AhmedHafez2000/Battery-Capacity-Tester/PCB/README.md

# Pritable PCB
It is a file for DIY project and it represents the bottom side of PCB.
The top side connections are jumper wires.
 
NOTE: Make sure to print the file in actual size scale
