AhmedHafez2000/Battery-Capacity-Tester/PCB/2D-Top.png

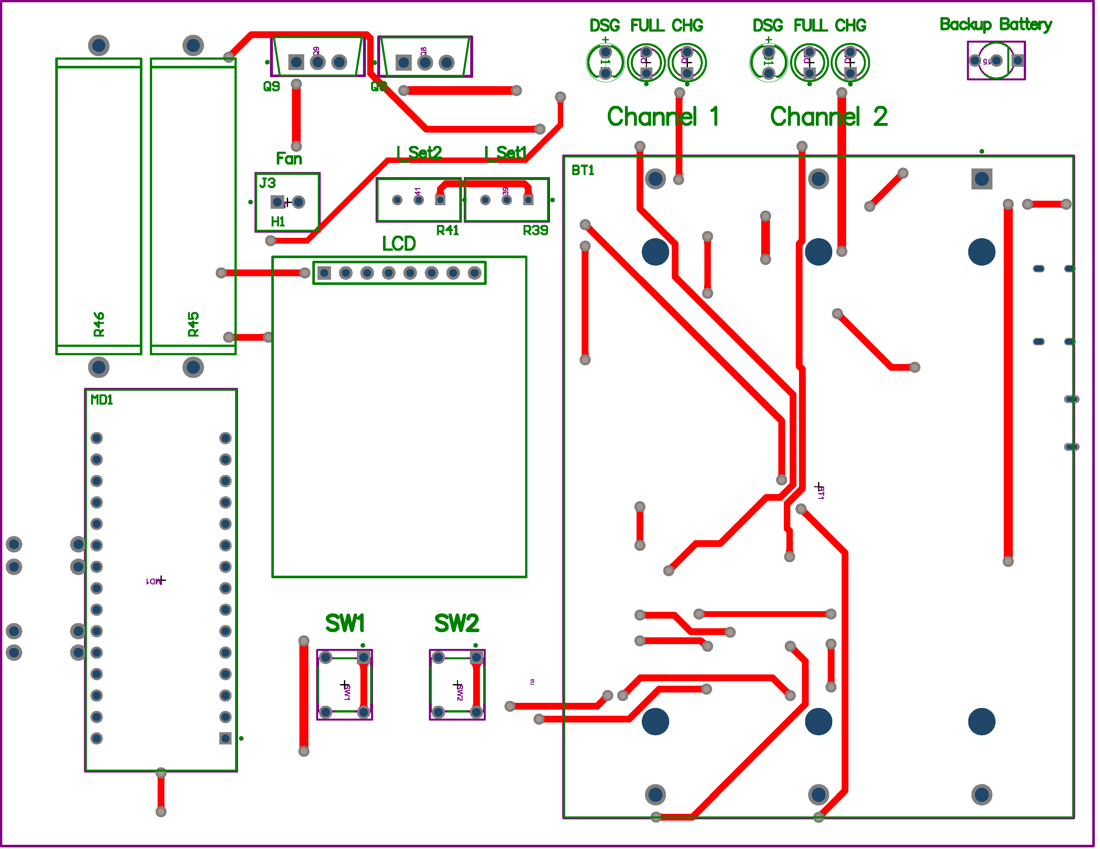
PCB/2D-Top.png
