AhmedHafez2000/Battery-Capacity-Tester/Photos/Current Calibaration Points.png

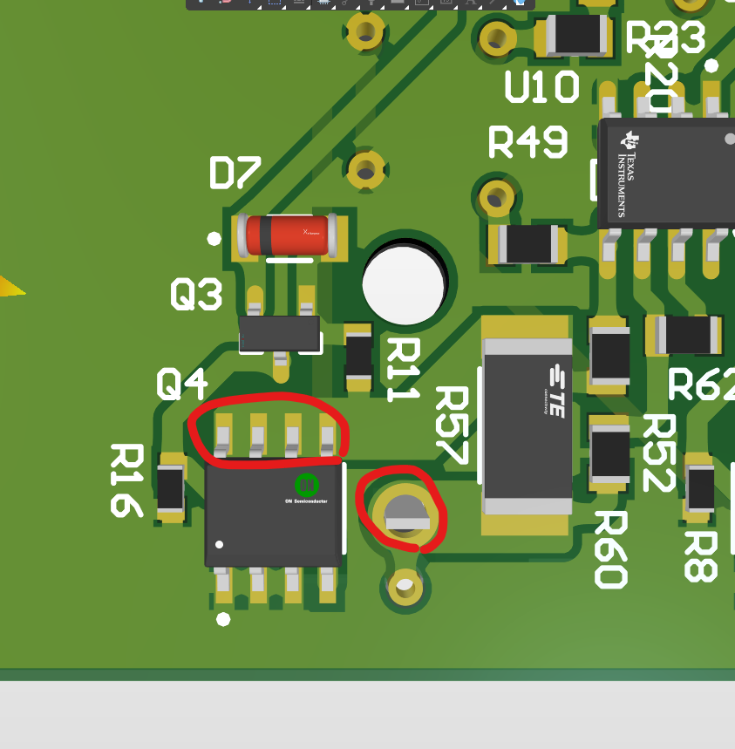
Photos/Current Calibaration Points.png
