AhmedHafez2000/Battery-Capacity-Tester/Photos/IMG_2.jpg

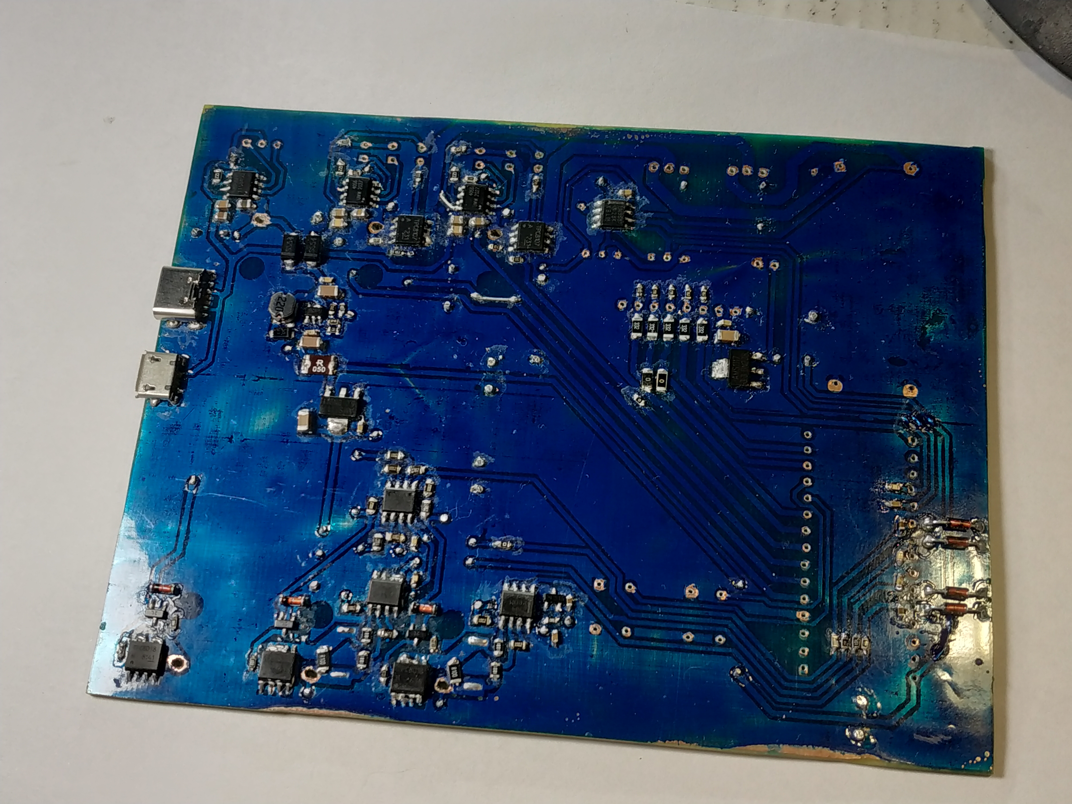
Photos/IMG_2.jpg
