AhmedHafez2000/Battery-Capacity-Tester/Photos/IMG_4.jpg

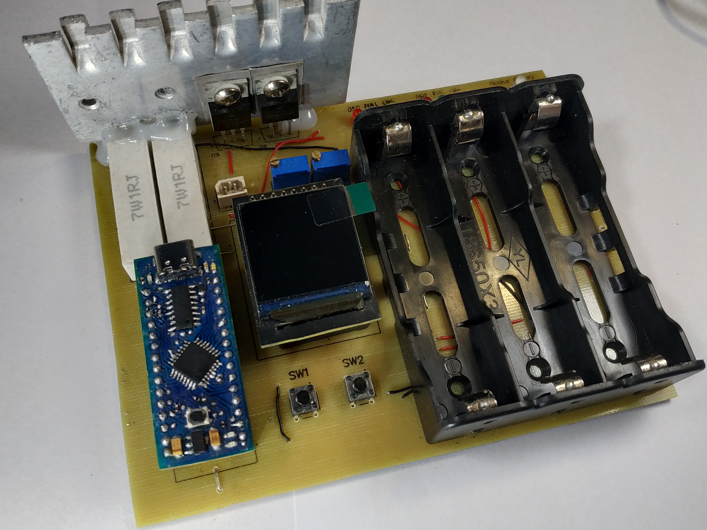
Photos/IMG_4.jpg
