AhmedHafez2000/Battery-Capacity-Tester/Photos/IMG_7.jpg

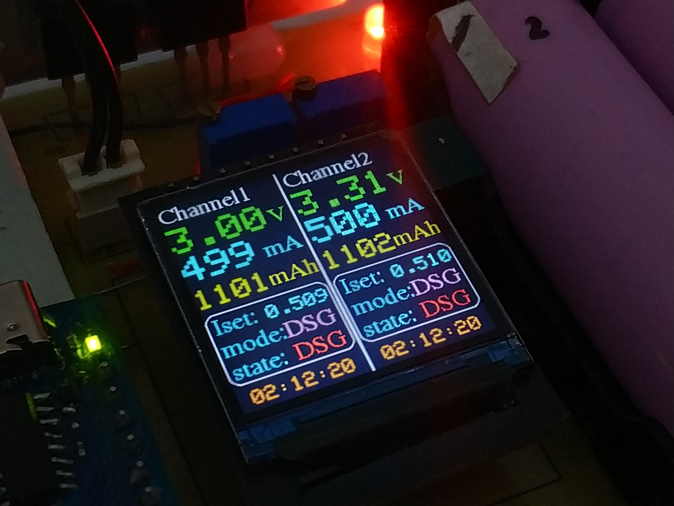
Photos/IMG_7.jpg
