AhmedHafez2000/Battery-Capacity-Tester/Photos/IMG_10.jpg

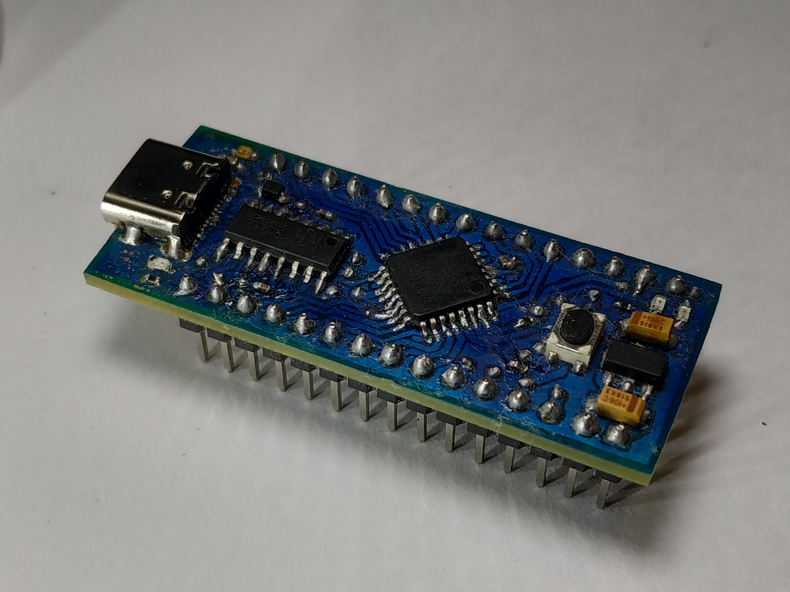
Photos/IMG_10.jpg
