AhmedHafez2000/Battery-Capacity-Tester/Schematic/Schematic_Battery_Tester.PDF

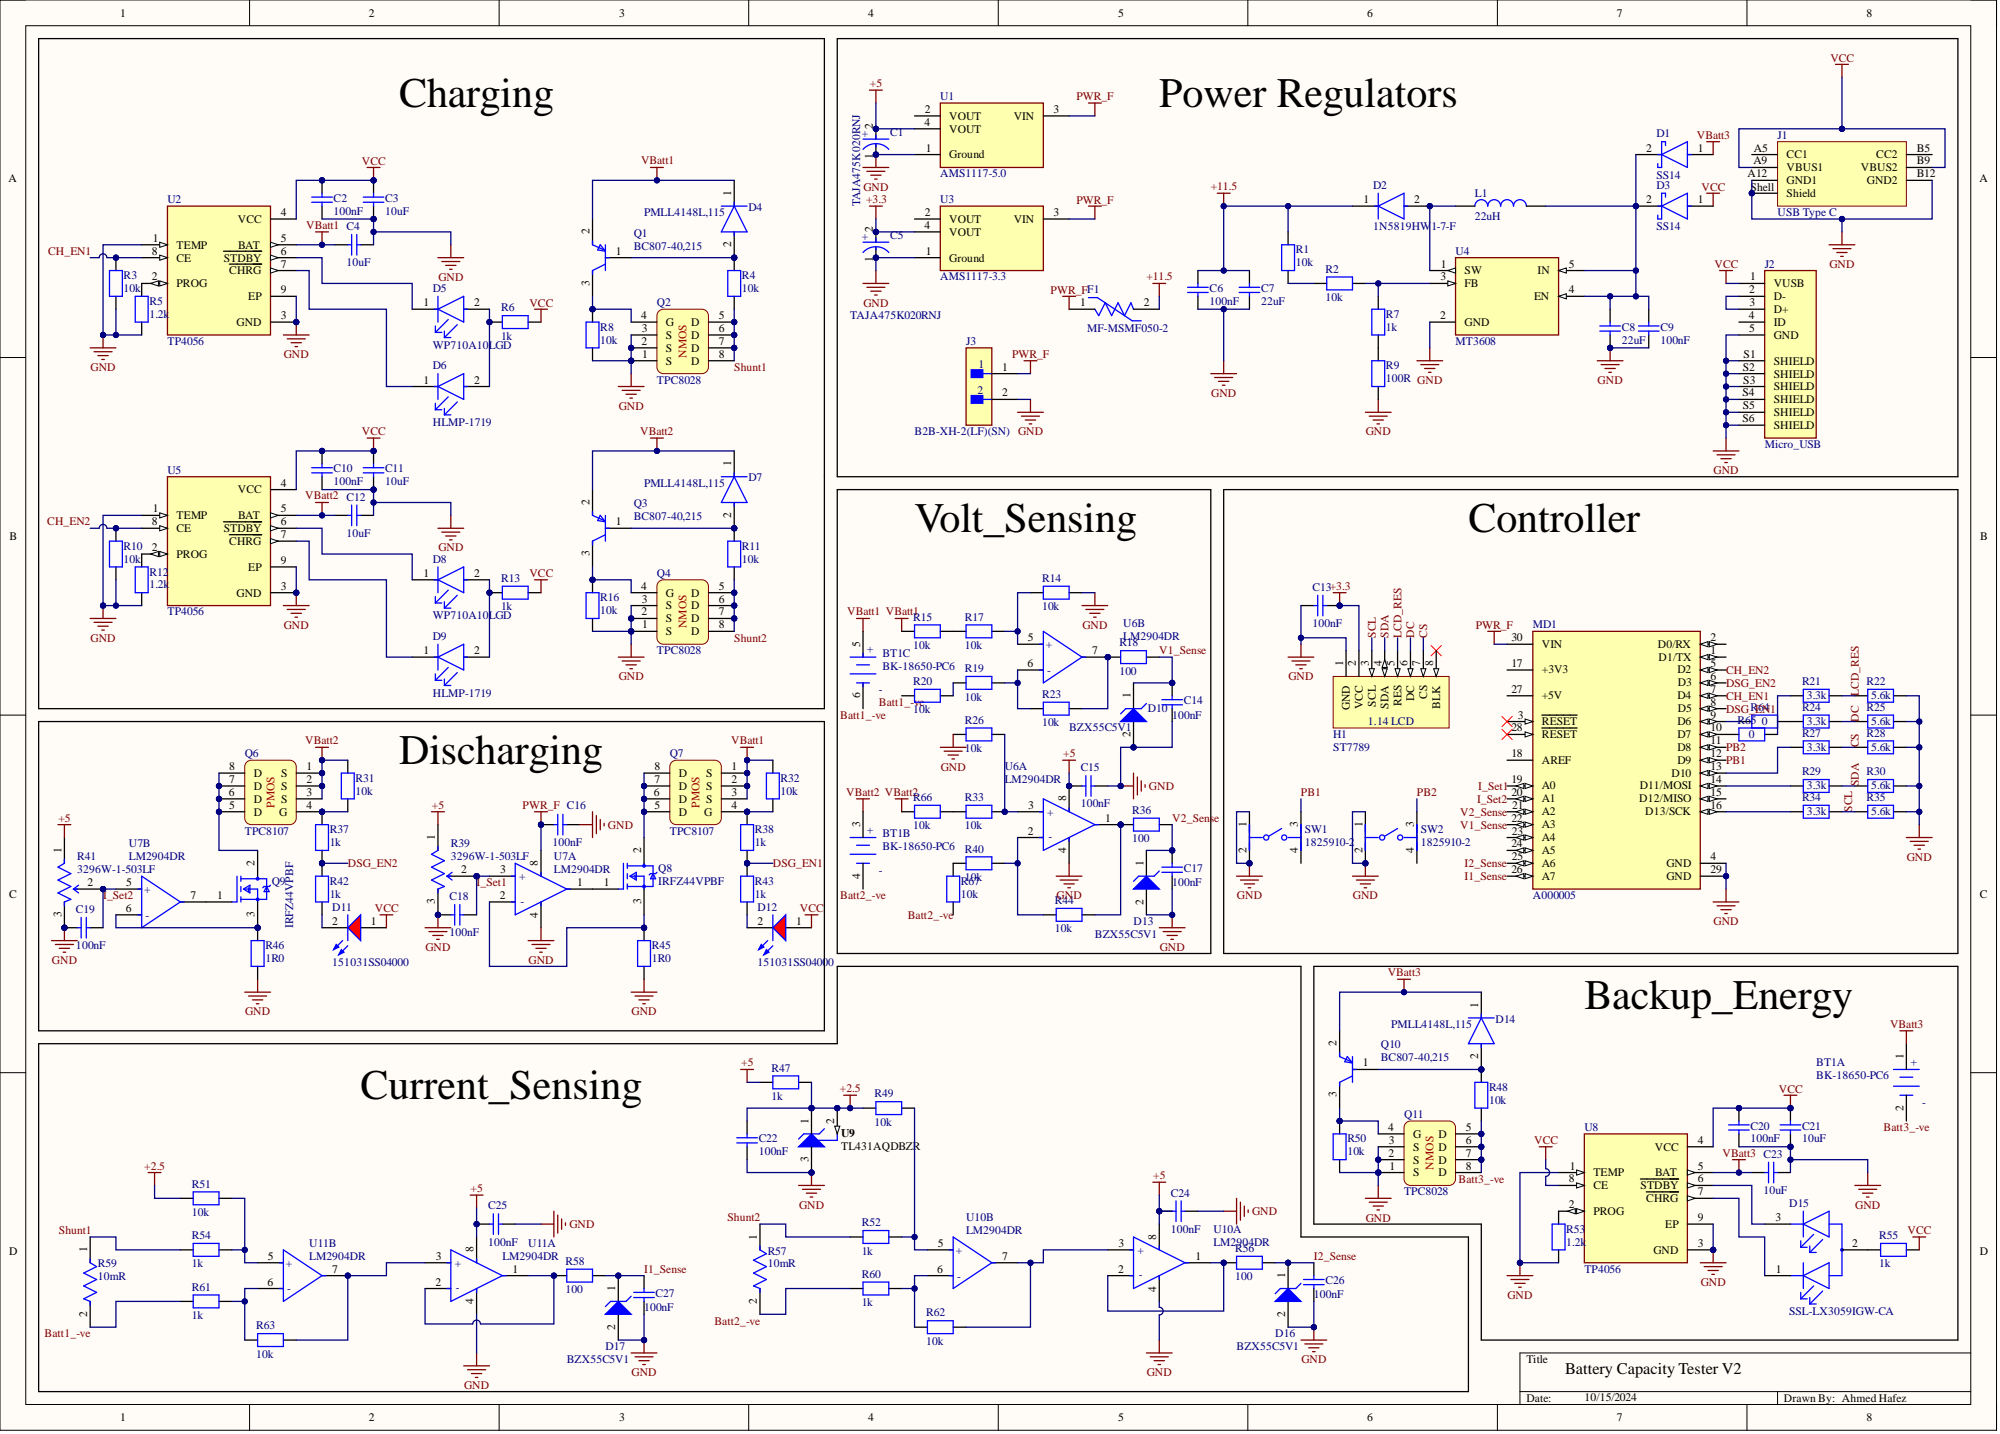
[picture p17: page 1]

B2B-XH-2(LF)(SN) GND
