AhmedHafez2000/Battery-Capacity-Tester/PCB/Batt_Tester.PDF

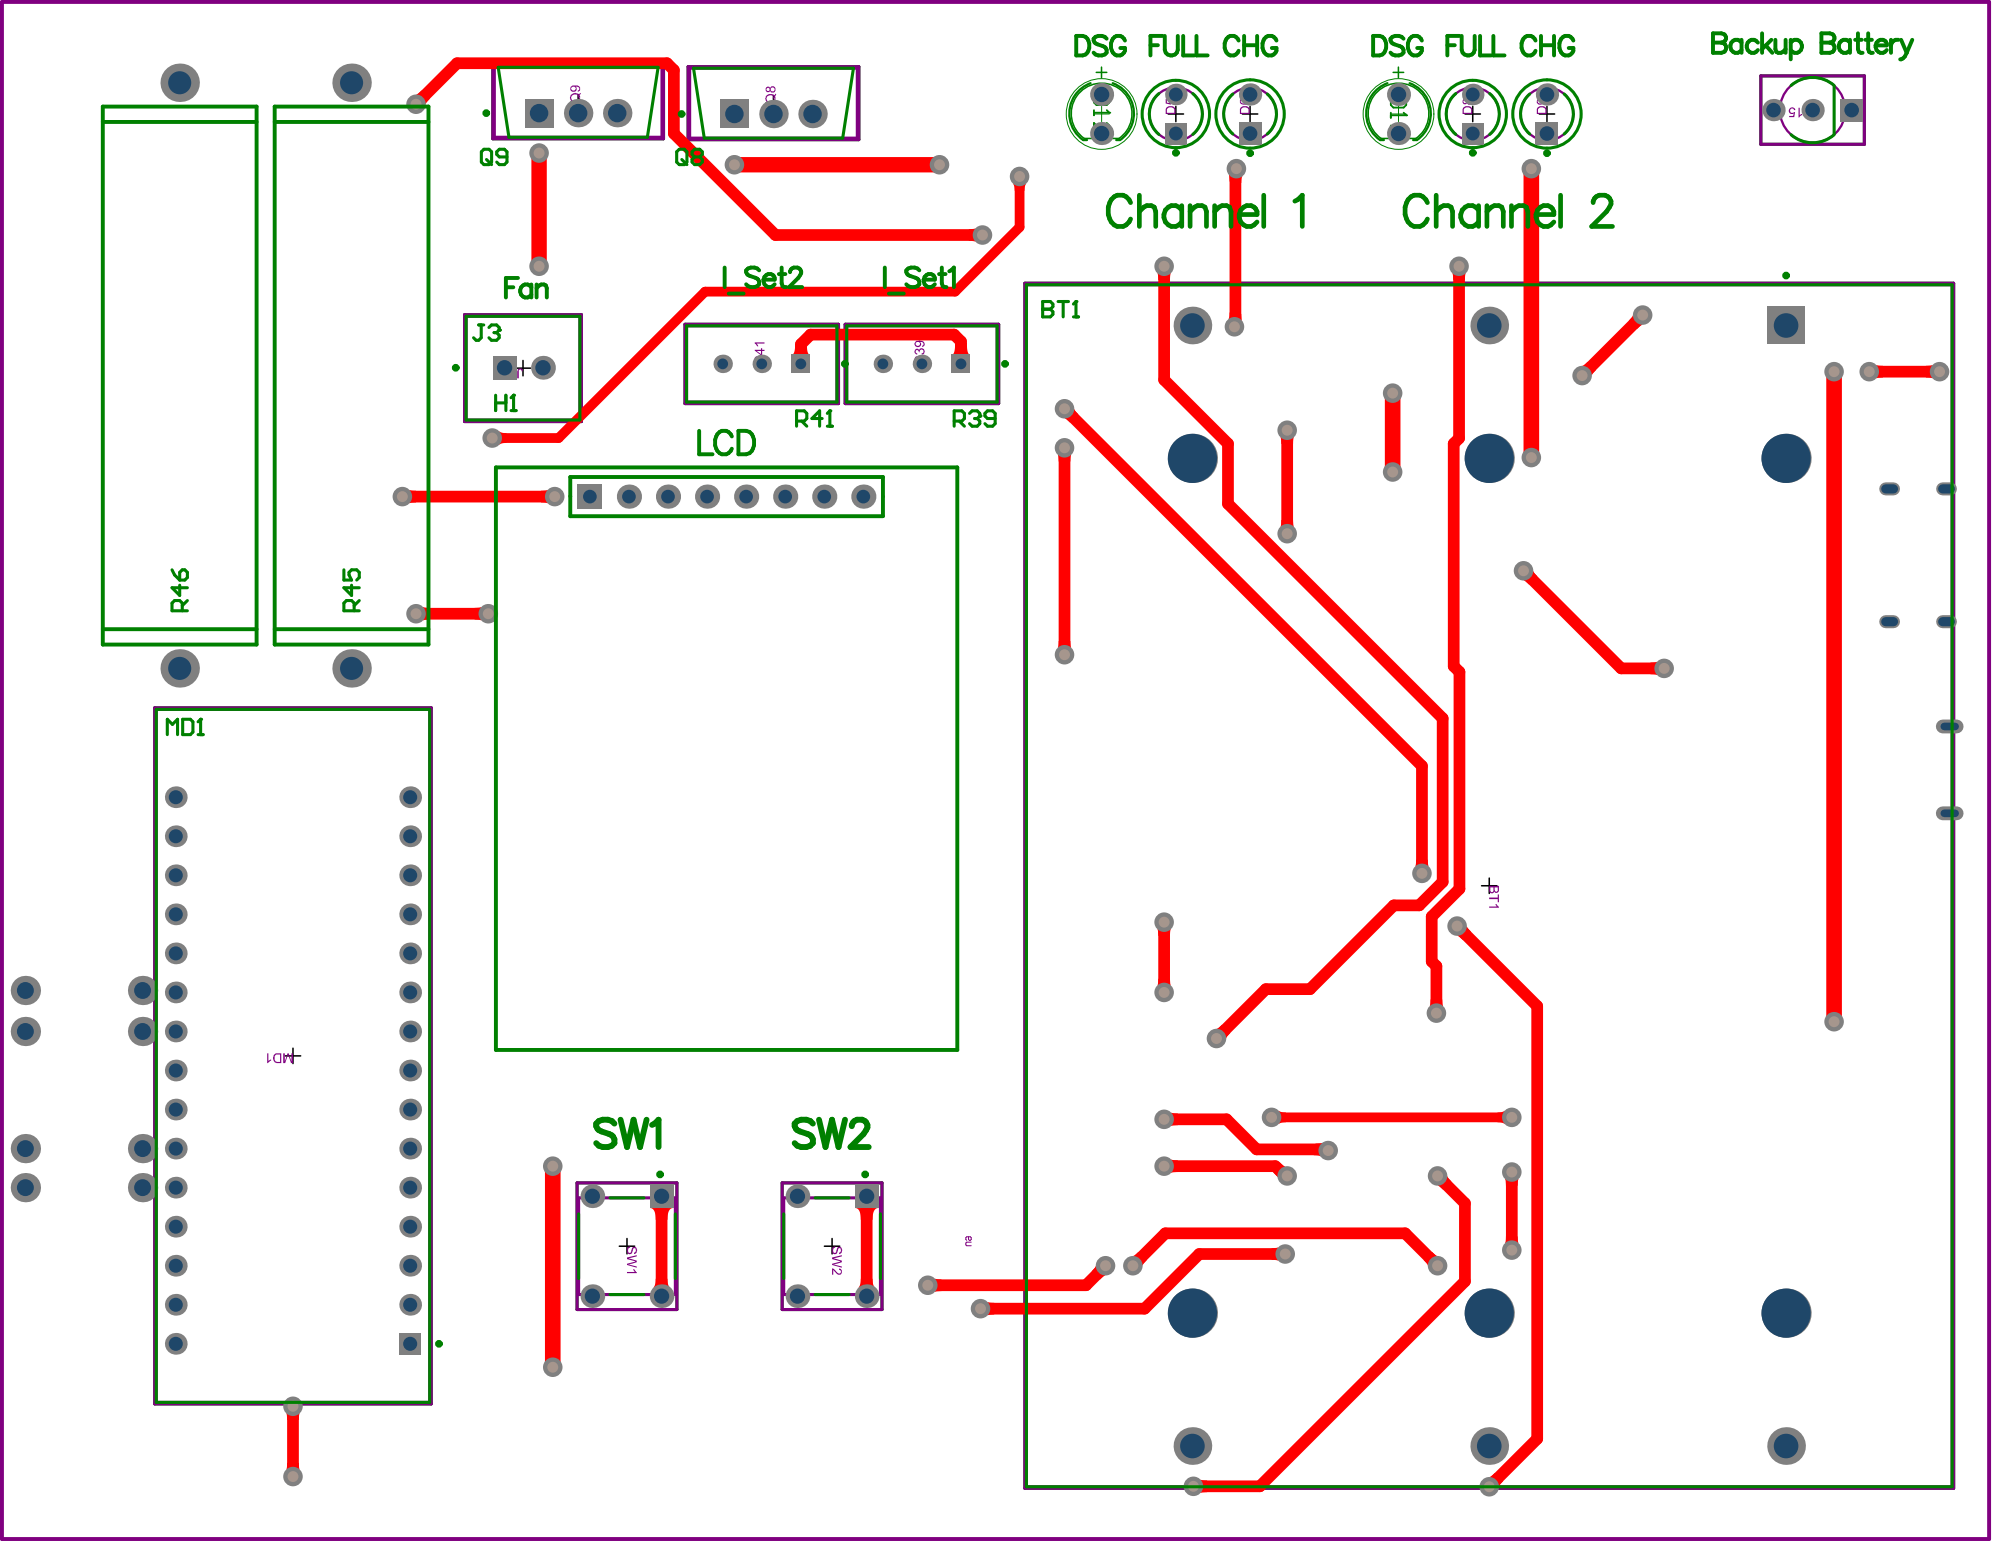
[picture p18: page 1]

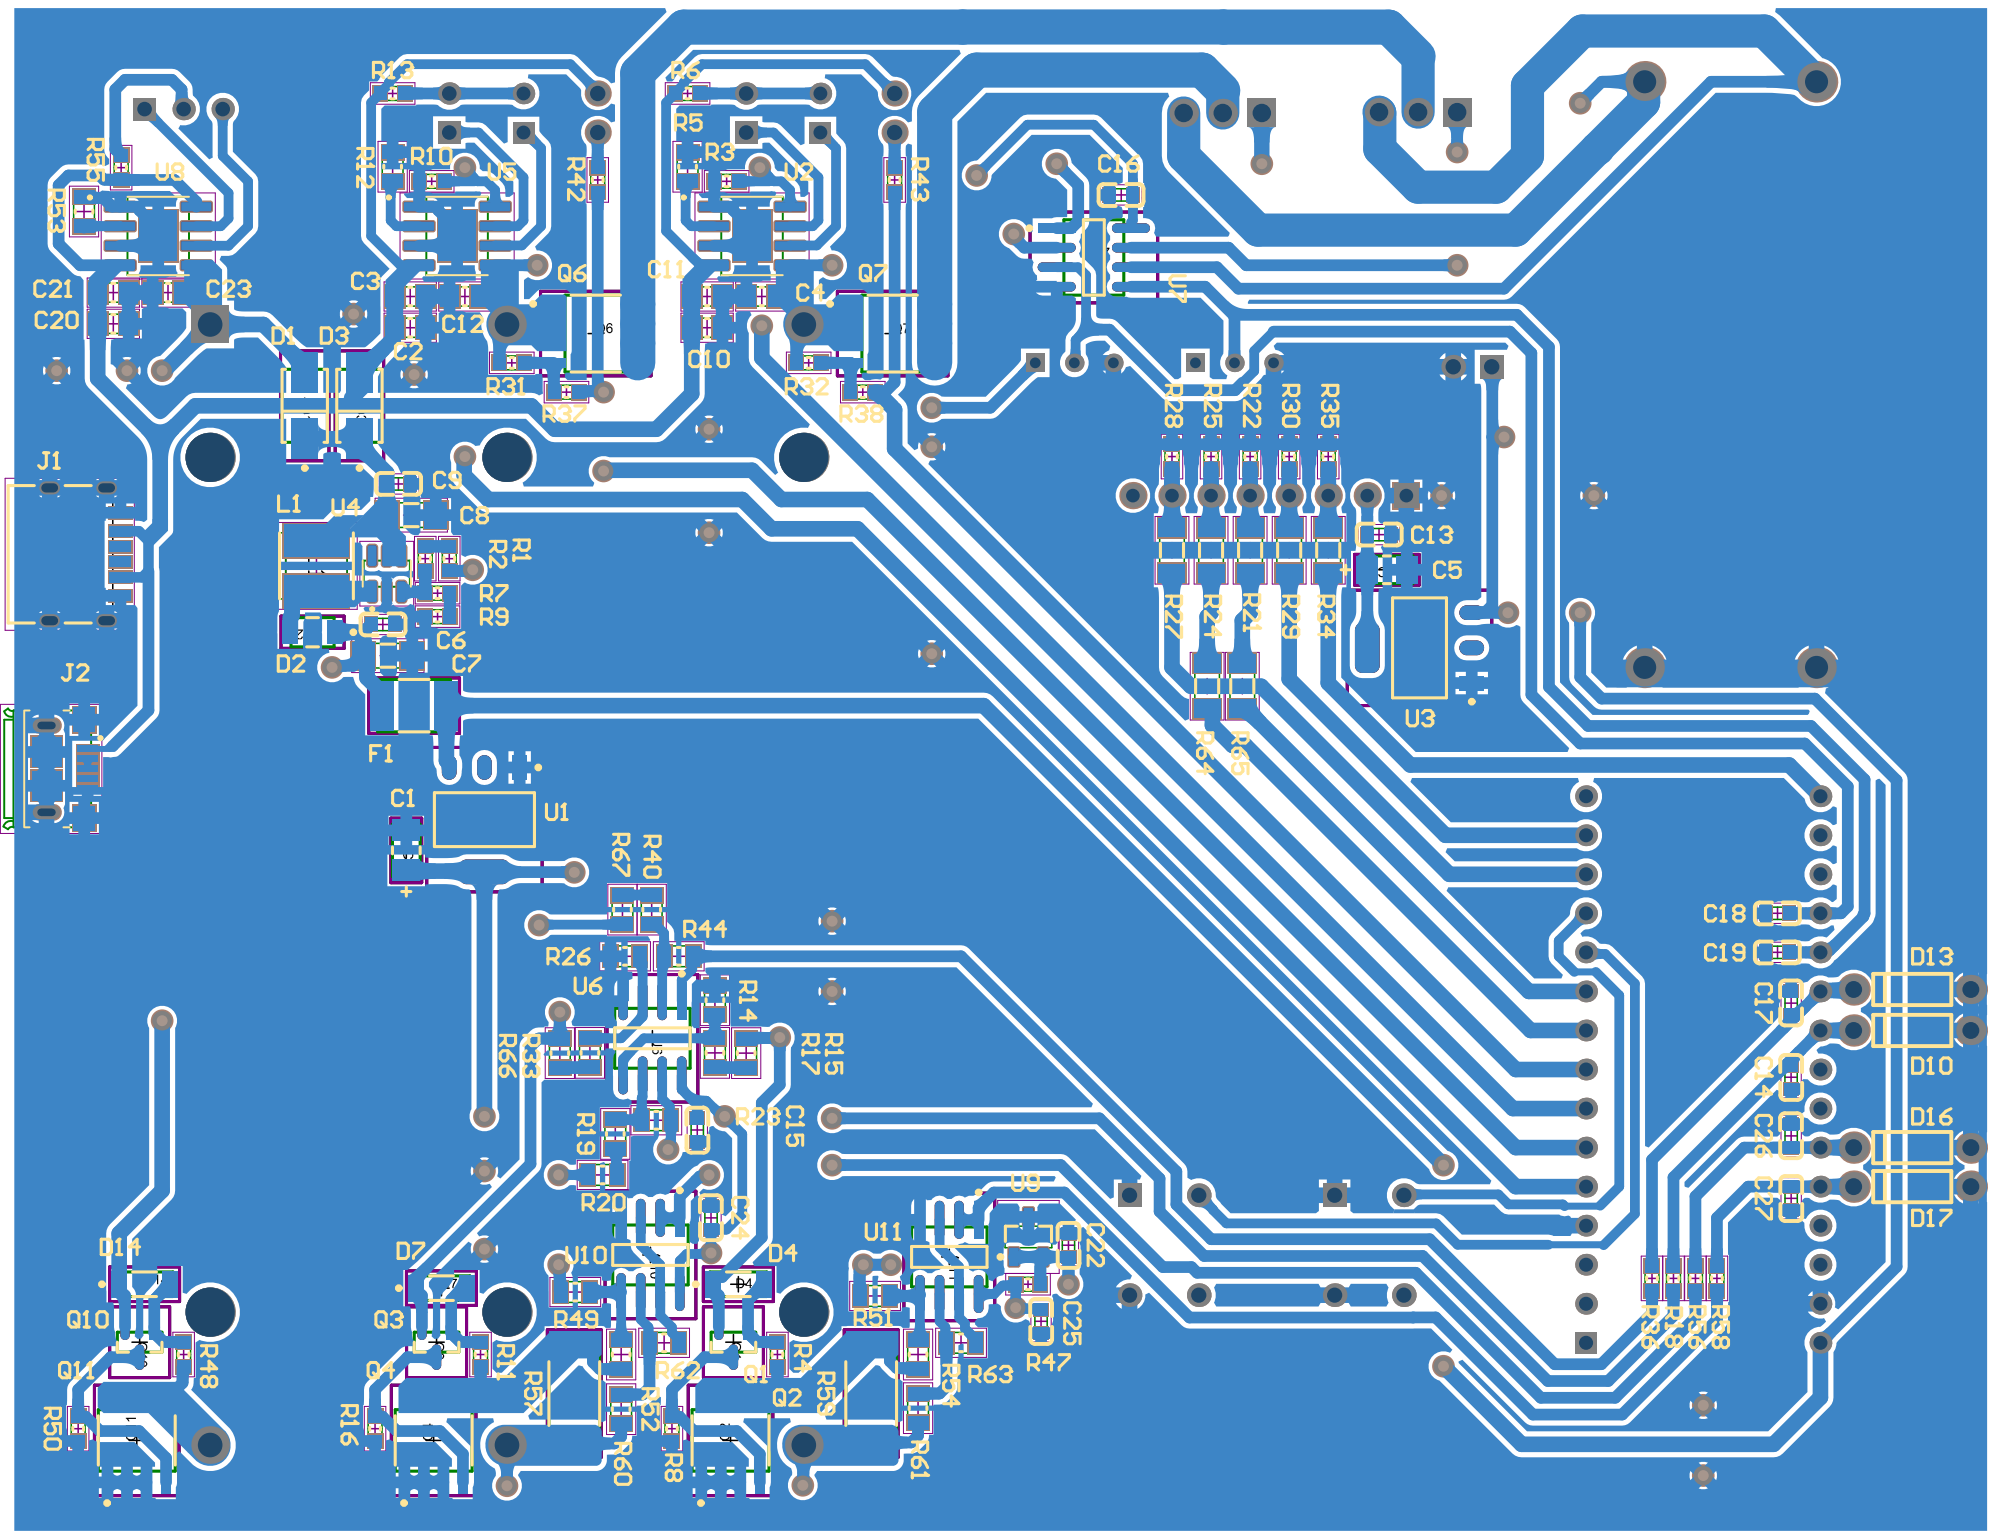
[picture p19: page 2]

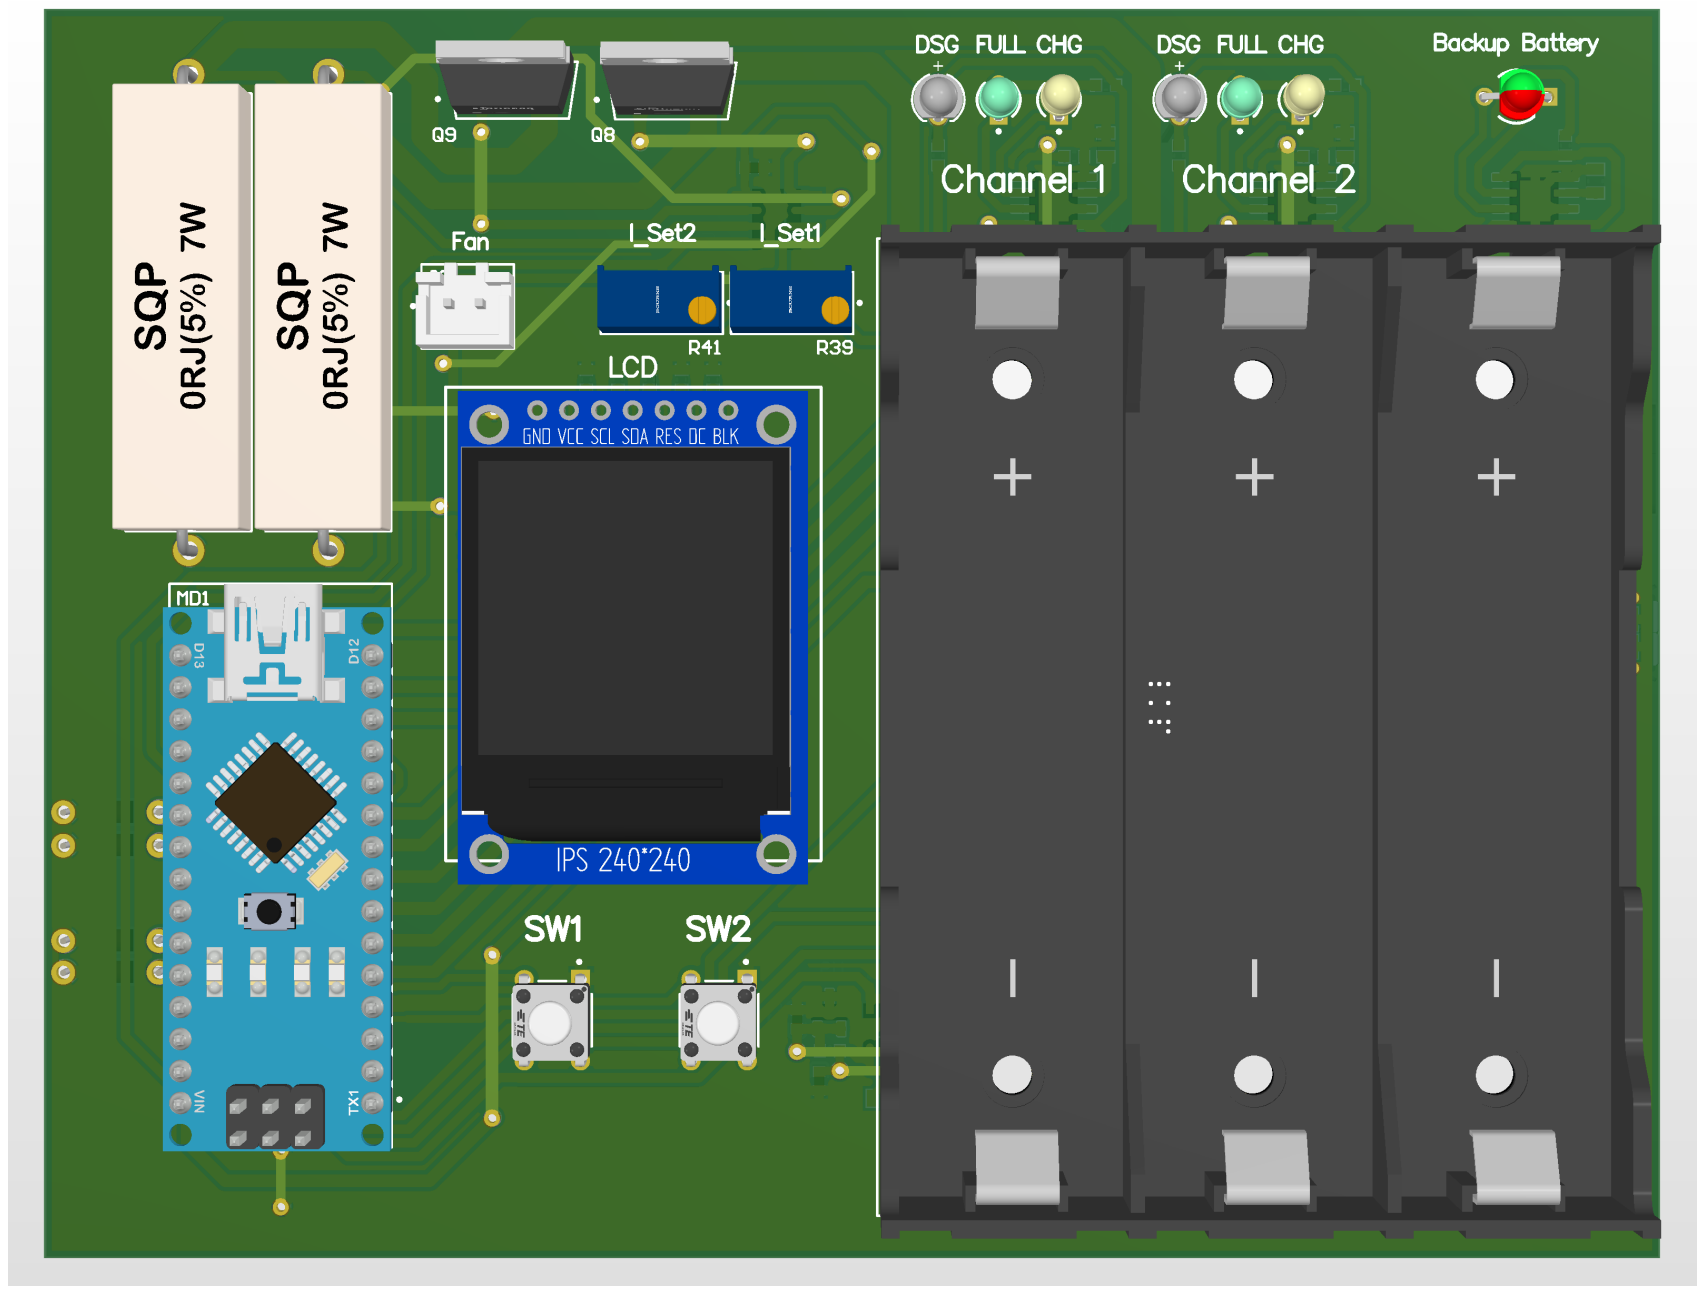
[picture p20: page 3]

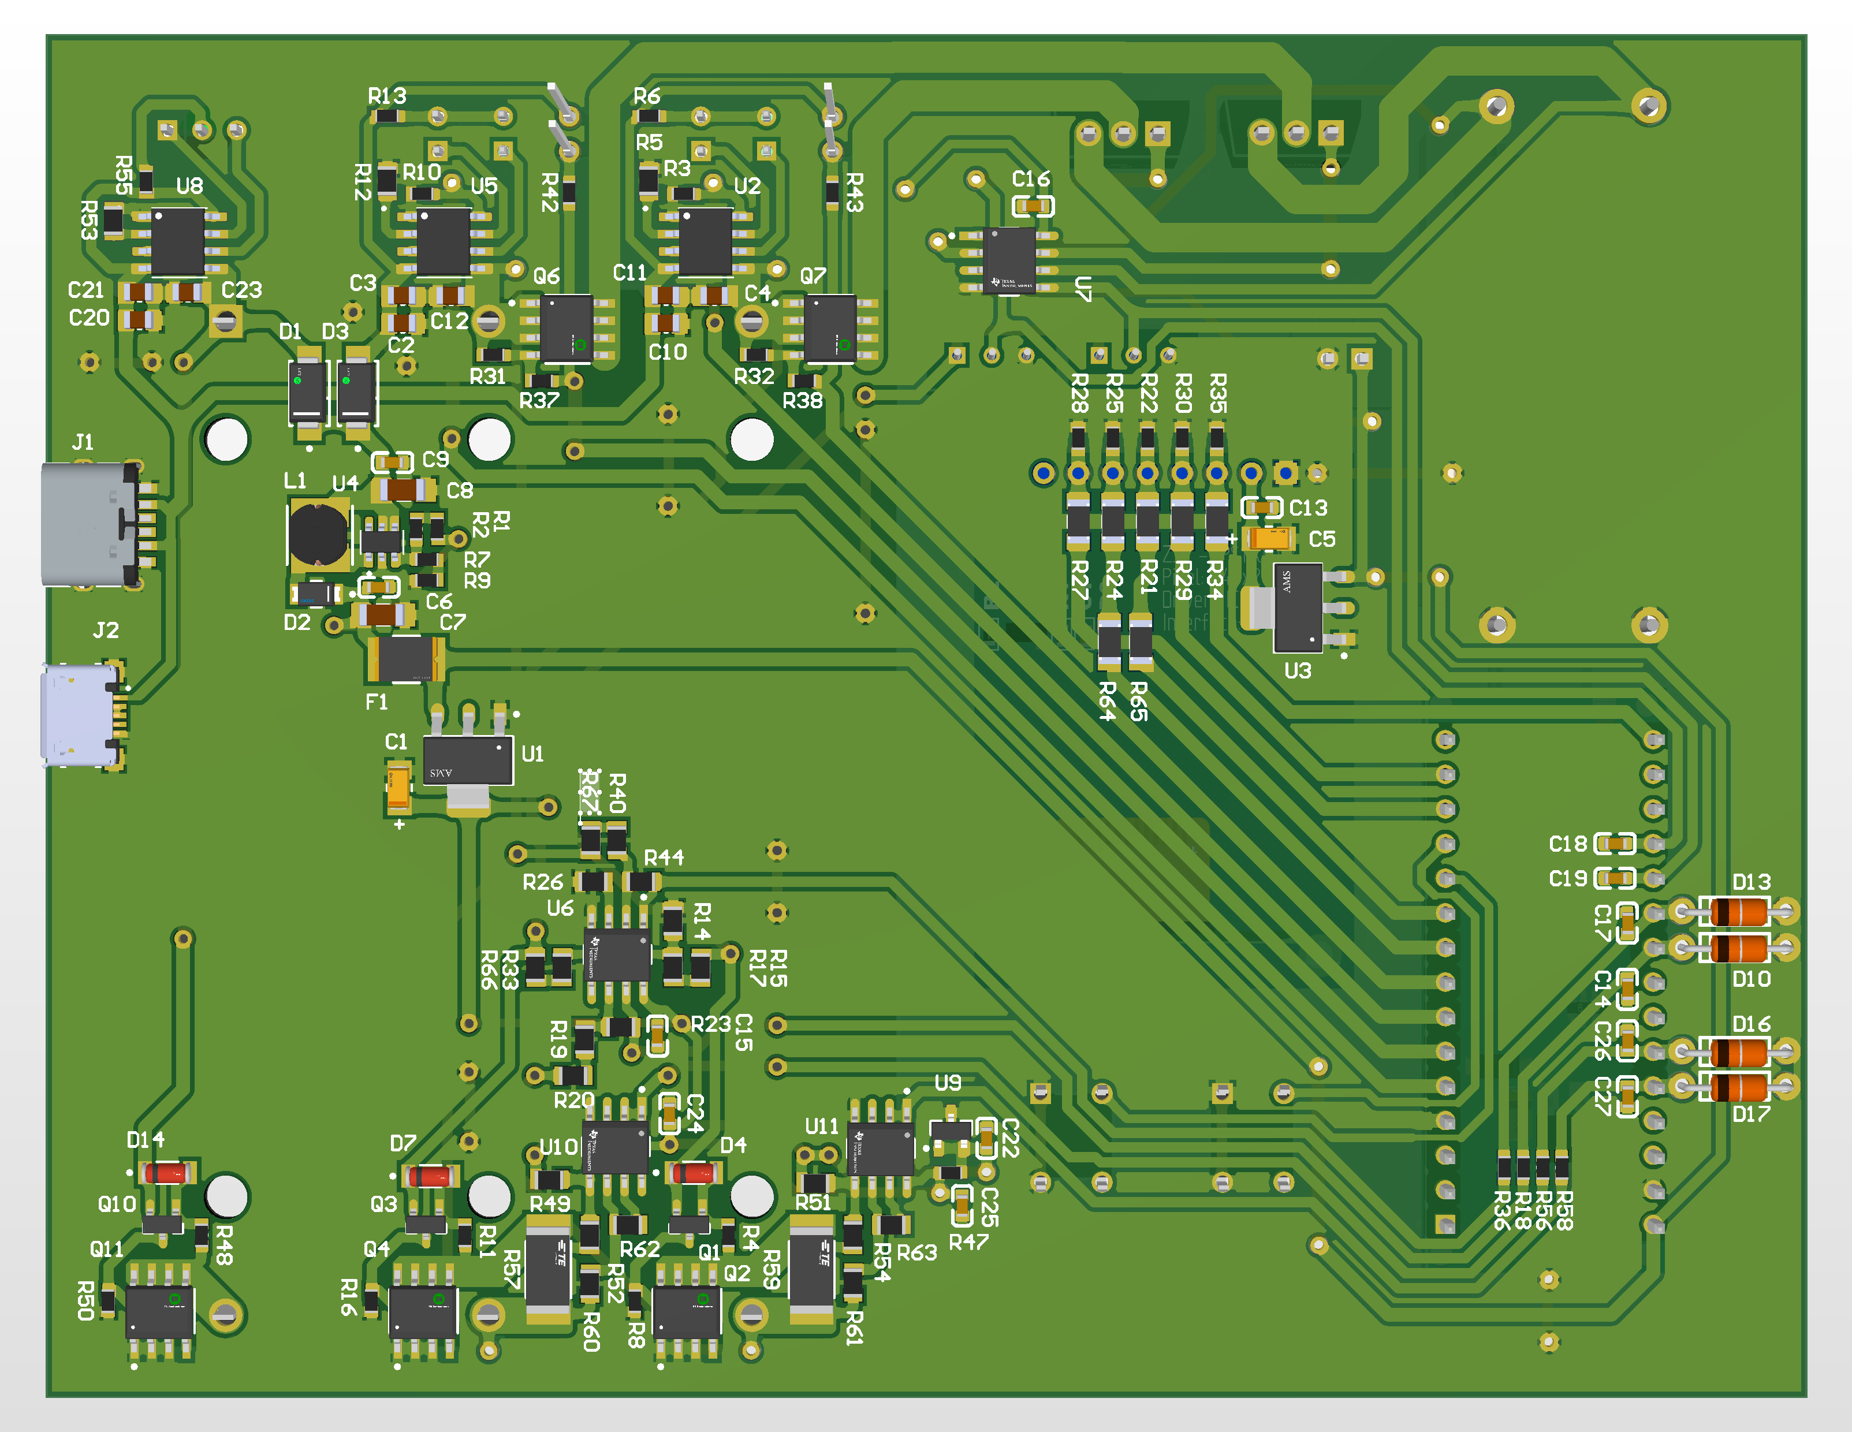
[picture p21: page 4]
