AhmedHafez2000/Battery-Capacity-Tester/PCB/Printable_PCB_Battery_Tester.pdf

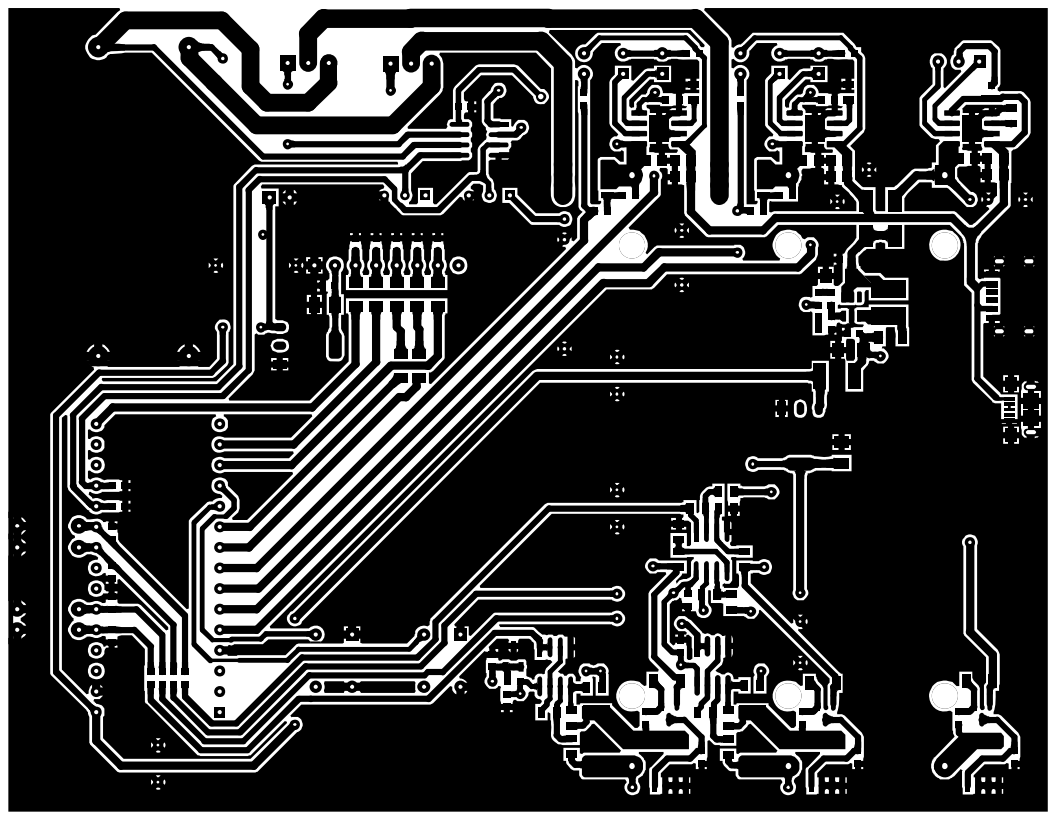
[picture p22: page 1]
